AbbottDevelopments/tesla-model3-meshcore-mount/cad/clip.step

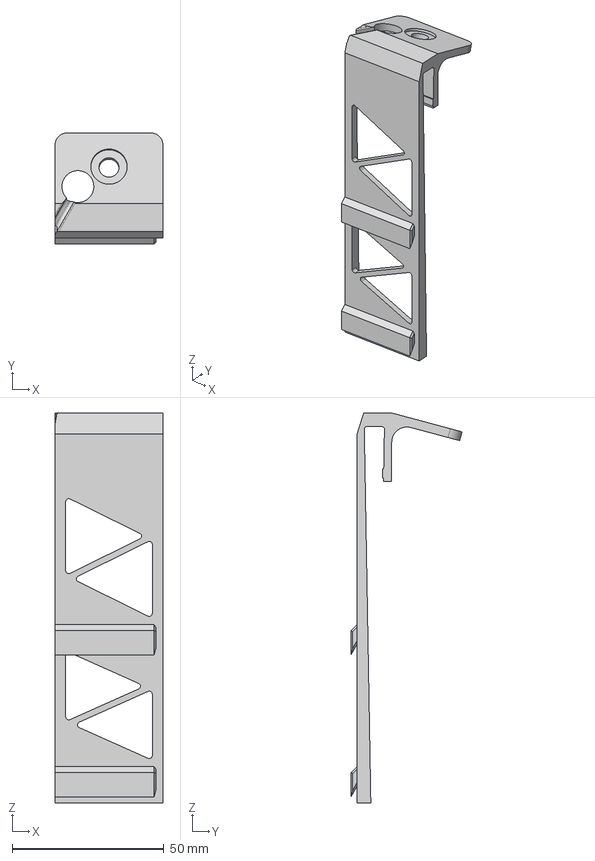
[picture p5: CAD file, 2026-10-17]
cad/clip.step
35.5 x 36.6 x 128.5 mm
