AbbottDevelopments/tesla-model3-meshcore-mount/cad/pocket.step

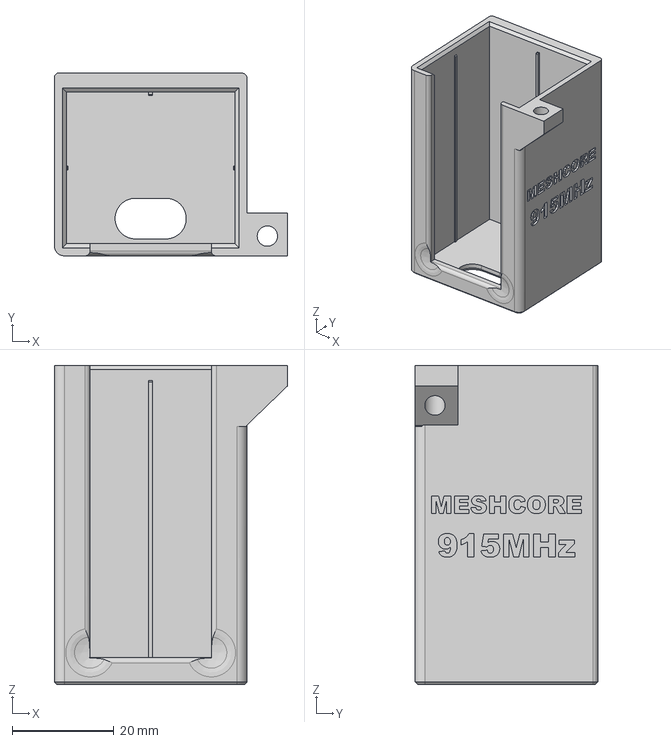
[picture p6: CAD file, 2026-10-17]
cad/pocket.step
45.9 x 36.0 x 62.8 mm
