AbbottDevelopments/tesla-model3-meshcore-mount/stl/clip_rear_door_4.10mm.stl

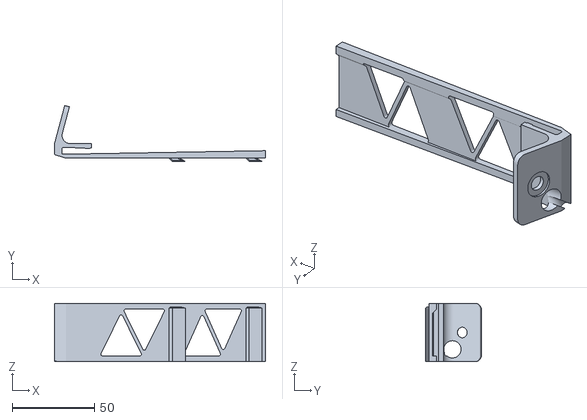
[picture p7: CAD file, 2026-10-17]
stl/clip_rear_door_4.10mm.stl
128.5 x 34.1 x 35.5
