AbbottDevelopments/tesla-model3-meshcore-mount/stl/glass_thickness_gauge_4.5-8.0mm.stl

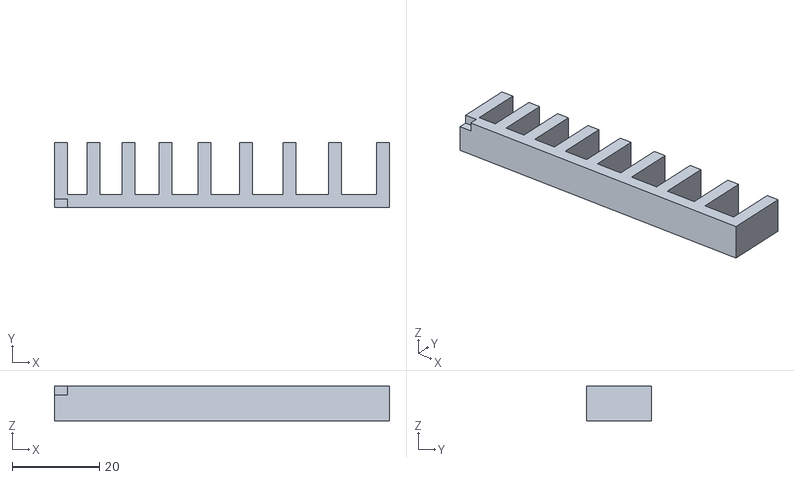
[picture p8: CAD file, 2026-10-17]
stl/glass_thickness_gauge_4.5-8.0mm.stl
77.0 x 15.0 x 8.00
