AbbottDevelopments/tesla-model3-meshcore-mount/(list of files, cad)

Other CAD files:
stl/clip_front_door_6.65mm.stl
stl/pocket_heltec_v3.stl
cad/meshcore-window-mount.f3d
