AbbottDevelopments/tesla-model3-meshcore-mount/(commit log)

2026-10-17 v1.0: MeshCore window mount for the 2022 Tesla Model 3
    Two-piece printed window mount (clip + radio pocket) for a Heltec WiFi
    LoRa 32 V3 running MeshCore, with the 915 MHz whip outside the car.
    Includes print-ready STLs, the parametric Fusion 360 model, STEP files,
    Ender-3 V2 G-code, parts list and CC BY-NC-SA 4.0 license.
    [clip_front_door_6.65mm.stl, clip_rear_door_4.10mm.stl, clip_v1.0.step, glass_thickness_gauge_4.5-8.0mm.stl, meshcore-window-mount-v1.0.f3d, pocket_heltec_v3.stl, pocket_v1.0.step]
2026-10-17 v1.1: text follows the pocket, renders, liability disclaimer
    - Fusion model: side-wall text and icon are dimensioned to the wall
    centre (wall_yc, wall_zc), so they stay centred when the radio size
    changes. Reference radio renamed Heltec V3 with a black screen.
    - README: four Fusion renders, "not crash tested" notice and a
    disclaimer / limitation of liability section.
    - CAD files renamed without version numbers. Printed geometry is
    unchanged from v1.0 (same STLs and G-code).
    [clip.step, meshcore-window-mount-v1.0.f3d, meshcore-window-mount.f3d, pocket.step]
